Andrii-Panchuk/2S-BATTERY-CHARGER/3D_Models/MPL-AL4020-xxx.STEP

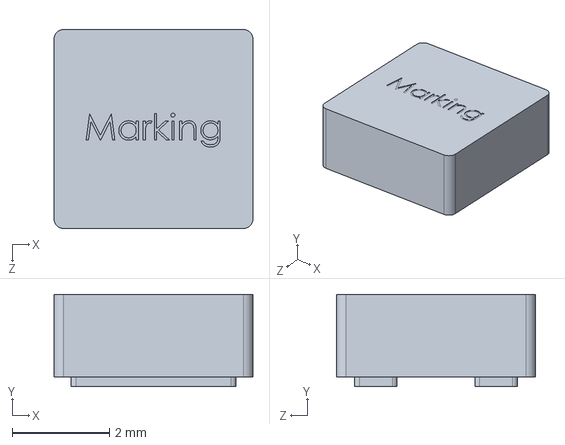
[picture p2: CAD file, 2026-11-10]
3D_Models/MPL-AL4020-xxx.STEP
4.10 x 1.90 x 4.10 mm
