Andrii-Panchuk/2S-BATTERY-CHARGER/LIB_HY2213-BB3A/HY2213-BB3A/3D/HY2213-BB3A.stp

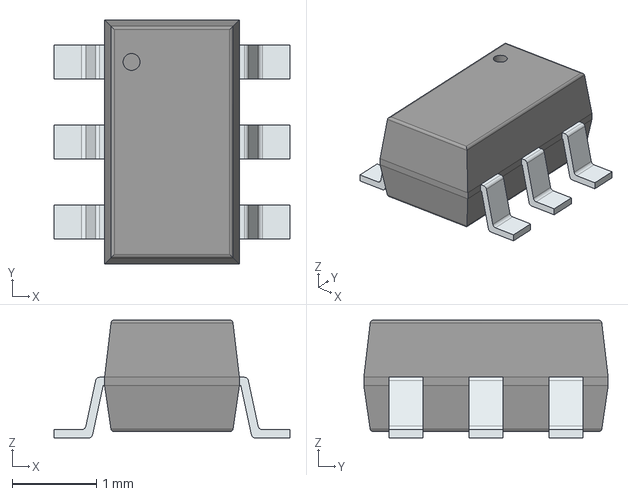
[picture p3: CAD file, 2026-09-07]
LIB_HY2213-BB3A/HY2213-BB3A/3D/HY2213-BB3A.stp
2.80 x 2.90 x 1.40 mm
PinsArrayLR
