Andrii-Panchuk/2S-BATTERY-CHARGER/(list of files, cad)

Other CAD files:
LIB_HY2213-BB3A/HY2213-BB3A/Allegro/sot95p280x140-6n.psm
LIB_HY2213-BB3A/HY2213-BB3A/DEHDL/hy2213_bb3a/chips/chips.prt
