Andrii-Panchuk/2S-BATTERY-CHARGER/docs/2S-BATTERY-CHARGER.pdf

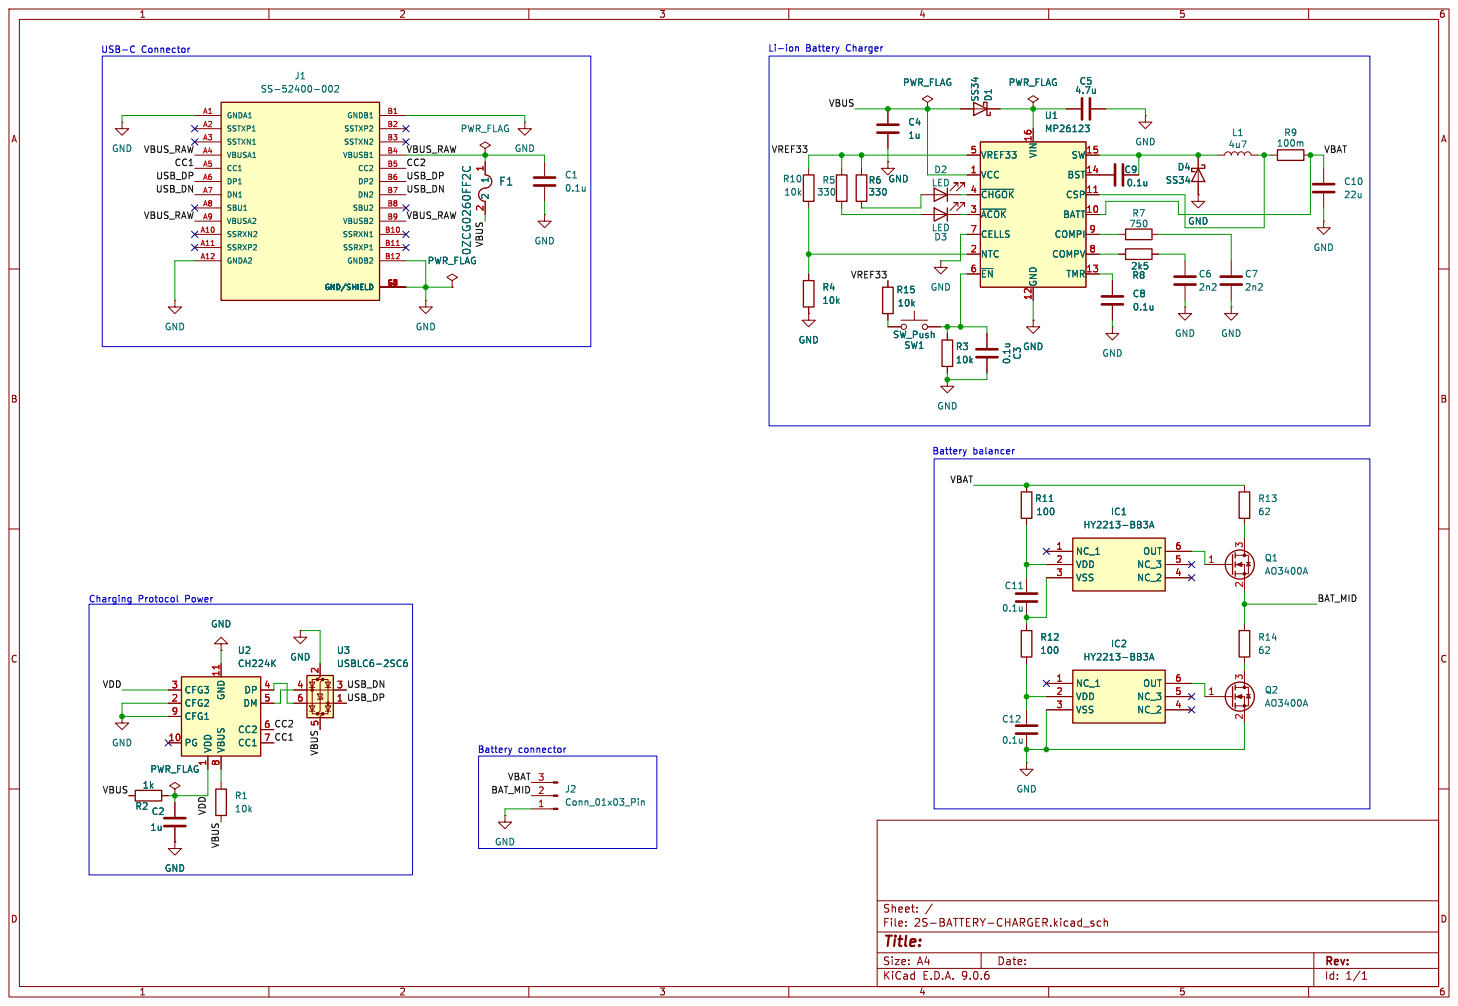
[picture p4: page 1]

Id: 1/1 Title: File: 2S-BATTERY-CHARGER.kicad_sch Sheet: /
