Andrii-Panchuk/2S-BATTERY-CHARGER/2S-BATTERY-CHARGER.kicad_pcb

## KiCad design 2S-BATTERY-CHARGER.kicad_pcb (2026-11-10)

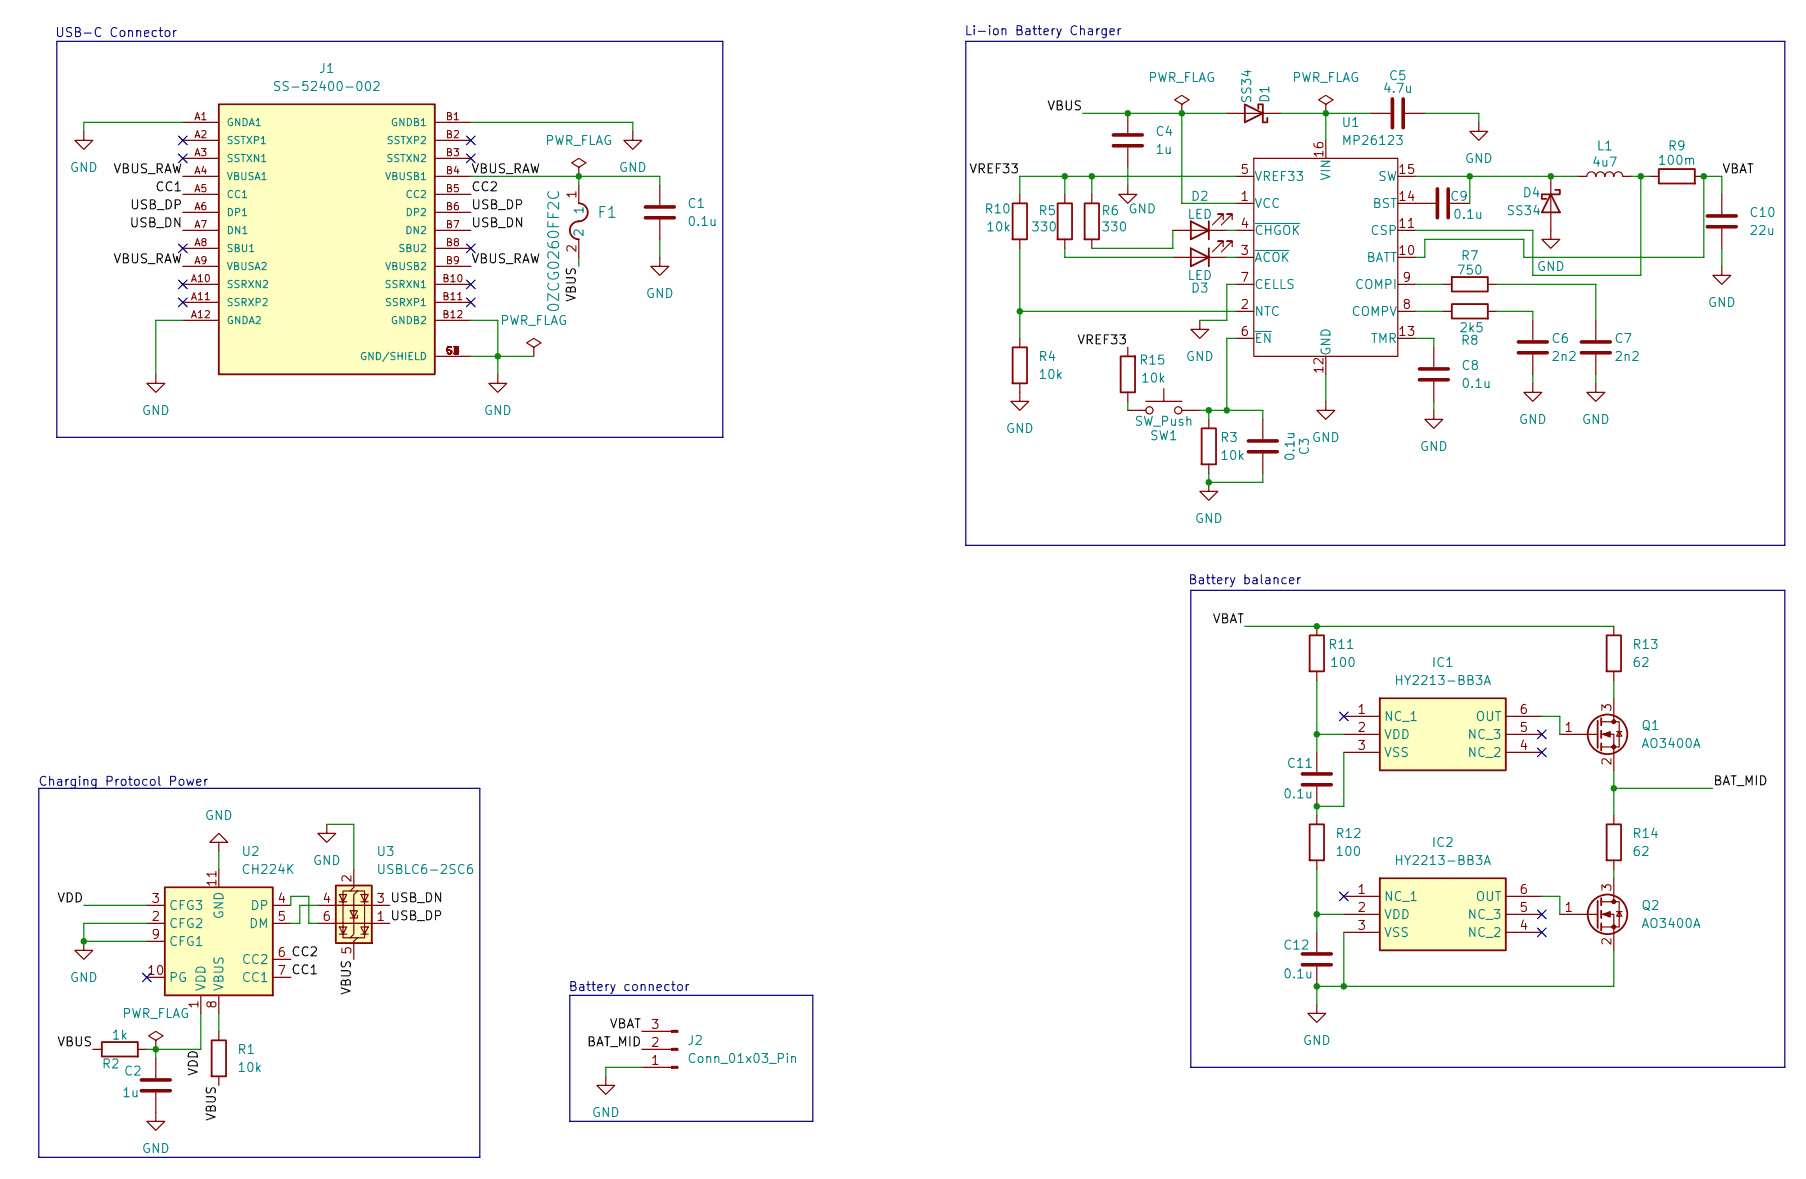
[picture p5: schematic 2S-BATTERY-CHARGER.kicad_sch]

Parts:
C1, C3, C8, C9, C11, C12: 0.1u; C_0805_2012Metric
C2, C4: 1u; C_0805_2012Metric
C5: 4.7u; C_1206_3216Metric
C6, C7: 2n2; C_0603_1608Metric
C10: 22u; C_1206_3216Metric
D1, D4: SS34; D_SMA
D2, D3: LED; LED_0805_2012Metric
F1: 0ZCG0260FF2C; Fuse_1812_4532Metric
IC1, IC2: HY2213-BB3A; SOT-23-6; Manufacturer_Part_Number HY2213-BB3A
J1: SS-52400-002; BELFUSE_SS-52400-002; PARTREV A0
J2: Conn_01x03_Pin; JST_EH_B3B-EH-A_1x03_P2.50mm_Vertical
L1: 4u7; L_7.3x7.3_H3.5
Q1, Q2: AO3400A; SOT-23
R1, R3, R4, R10, R15: 10k; R_0805_2012Metric
R2: 1k; R_0805_2012Metric
R5, R6: 330; R_0805_2012Metric
R7: 750; R_0805_2012Metric
R8: 2k5; R_0805_2012Metric
R9: 100m; R_1206_3216Metric
R11, R12: 100; R_0805_2012Metric
R13, R14: 62; R_1206_3216Metric
SW1: SW_Push; SW_SPST_TL3342
U1: MP26123; QFN-16-1EP_4x4mm_P0.65mm_EP2.5x2.5mm
U2: CH224K; SSOP-10-1EP_3.9x4.9mm_P1mm_EP2.1x3.3mm
U3: USBLC6-2SC6; SOT-23-6

Connections:
/BAT_MID: J2.2, Q1.2 (S), R14.1
/CC1: J1.A5 (CC1), U2.7 (CC1)
/CC2: J1.B5 (CC2), U2.6 (CC2)
/USB_DN: J1.A7 (DN1), J1.B7 (DN2), U3.3 (I/O2)
/USB_DP: J1.A6 (DP1), J1.B6 (DP2), U3.1 (I/O1)
/VBAT: C10.1, J2.3, R9.2, R11.1, R13.1, U1.10 (BATT)
/VBUS: C4.1, D1.2 (A), F1.2, R1.2, R2.1, U1.1 (VCC), U3.5 (VBUS)
/VBUS_RAW: C1.1, F1.1, J1.A4 (VBUSA1), J1.A9 (VBUSA2), J1.B4 (VBUSB1), J1.B9 (VBUSB2)
/VDD: C2.1, R2.2, U2.1 (VDD), U2.3 (CFG3)
/VREF33: R5.1, R6.1, R10.1, R15.2, U1.5 (VREF33)
GND: C1.2, C2.2, C3.2, C4.2, C5.2, C6.2, C7.2, C8.2, C10.2, C12.2, D4.2 (A), IC2.3 (VSS), J1.A1 (GNDA1), J1.A12 (GNDA2), J1.B1 (GNDB1), J1.B12 (GNDB2), J1.G1 (GND/SHIELD), J1.G2 (GND/SHIELD), J1.G3 (GND/SHIELD), J1.G4 (GND/SHIELD), J1.S1 (GND/SHIELD), J1.S2 (GND/SHIELD), J1.S3 (GND/SHIELD), J1.S4 (GND/SHIELD), J2.1, Q2.2 (S), R3.2, R4.2, U1.7 (CELLS), U1.12 (GND), U1.17, U2.2 (CFG2), U2.9 (CFG1), U2.11 (GND), U3.2 (GND)
unnamed: C6.1, R8.2
unnamed: C7.1, R7.1
unnamed: C5.1, D1.1 (K), U1.16 (VIN)
unnamed: D2.2 (A), R6.2
unnamed: D2.1 (K), U1.4 (~CHGOK)
unnamed: D3.2 (A), R5.2
unnamed: D3.1 (K), U1.3 (~ACOK)
unnamed: C9.1, D4.1 (K), L1.1, U1.15 (SW)
unnamed: IC1.6 (OUT), Q1.1 (G)
unnamed: C11.1, IC1.2 (VDD), R11.2
unnamed: C11.2, IC1.3 (VSS), R12.1
unnamed: IC2.6 (OUT), Q2.1 (G)
unnamed: C12.1, IC2.2 (VDD), R12.2
unnamed: Q1.3 (D), R13.2
unnamed: Q2.3 (D), R14.2
unnamed: R15.1, SW1.1
unnamed: C9.2, U1.14 (BST)
unnamed: R7.2, U1.9 (COMPI)
unnamed: R8.1, U1.8 (COMPV)
unnamed: L1.2, R9.1, U1.11 (CSP)
unnamed: R4.1, R10.2, U1.2 (NTC)
unnamed: C8.1, U1.13 (TMR)
unnamed: C3.1, R3.1, SW1.2, U1.6 (~EN)
unnamed: U2.5 (DM), U3.4 (I/O2)
unnamed: U2.4 (DP), U3.6 (I/O1)
unnamed: R1.1, U2.8 (VBUS)

Notes on the sheet:
Battery balancer
Li-ion Battery Charger
Charging Protocol Power
Battery connector
USB-C Connector

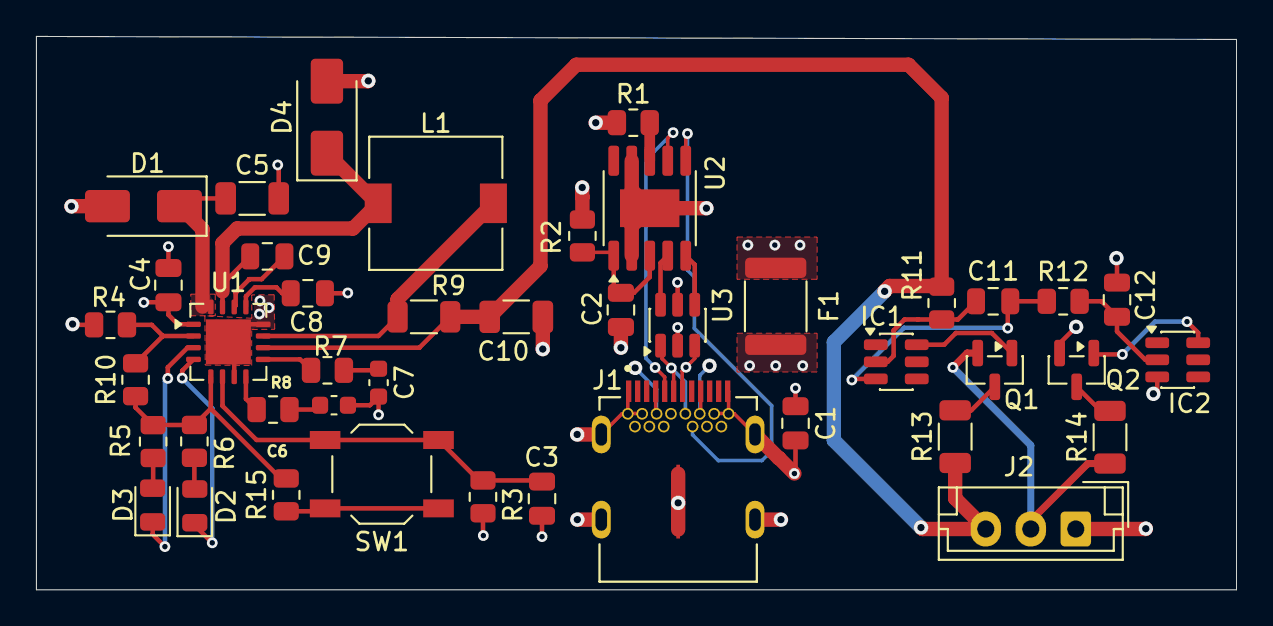
[picture p6: board 2S-BATTERY-CHARGER.kicad_pcb from above]

Board: 4 copper layers, 66.7 x 30.7 mm, 43 parts (0 on the bottom side), 37 nets.
