Andrii-Panchuk/2S-BATTERY-CHARGER/(commit log)

2026-11-10 Remove KiCad autosave/lock files, add .gitignore and .gitattributes
2026-11-10 docs: add schematic photo
2026-11-10 docs: add schematic svg photo and remove scematic pdf photo
2026-11-10 docs: add PCB photo
